LHC324/ABB-Technical-commutation_new/document/迪文屏幕变动说明.txt

1、首页：加入RTC。
2、开发者模式：加时间、亮度设置、网络时间获取、屏幕时间下发、wifi串口参数。
3、自动测试、手动测试电压单位V、电流单位mA，偏差率单位%。
4、分级手动：交直流选项框去掉（段号变更为组号）。
5、手动测试：段号：起始段号、结束段号。
6、段号变更为组号，原来8段变为7组。每3个端点为1组。（分级手动）
7、用户频率设定部分：仅预留低频（0HZ）、中频（50HZ）、高频（1-20Khz）选项框。
8、开发者模式：去掉段号、增加一个wifi复位按钮、WiFi恢复出厂设置按钮。
9、自动模式、手动模式去掉数据保存按钮。
