LHC324/ABB-Technical-commutation_new/document/Sphinx/高压断路器动特性测试仪使用说明书  V1.0.1 .pdf

- » 高压断路器动特性测试仪 V1.0.1 文档

# 高压断路器动特性测试仪使用说明书

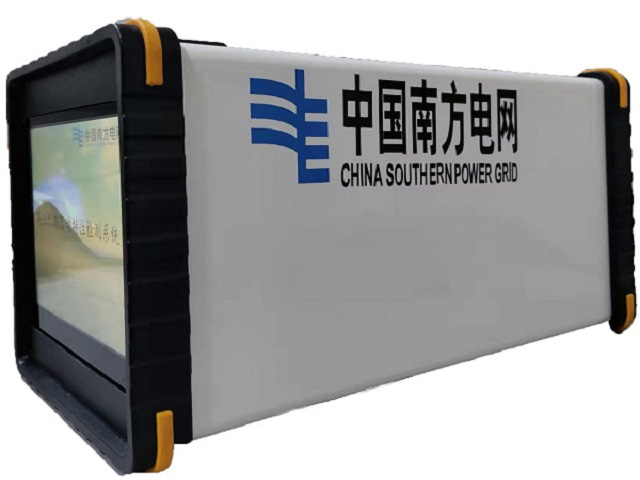
[picture p16: figure]

公司主页（homepage）：http://www.ynpax.com/cn/home/index.asp合作方主页：http://www.yn.csg.cn/
公司地址:云南省昆明市经开区云大西路39号创业大厦C栋202室
联系电话:0871-6732300/67322190
目录

## 1. 概述

本产品为高压断路器动特性测试仪，公司遵循国家行业执行标准： GB10963.1-2005 ,确属本公司 产品质量问题，自购置之日起保修期为3个月(非正常使用而致使产品损坏，烧坏的，不属保 修之列)。

高压断路器是高低压电器回路中执行线路通断的执行机构，承担着线路合闸、分闸工作。 断路器性能的好坏直接影响着输变电环节的安全生产过程，因此在各换流站大量使用的高 压断路器需要保持持续有效的性能检测。 然而，由于高压断路器安装位置高、使用数量 多，在传统的生产检测环节，需要动用大型辅助升降设备协助操作人员进行断路器检测信 号线的接驳和断开，不仅生产效率低下，而且存在高危、高风险、工作量巨大、协同人员 多的诸多缺点。为了降低换流站检修人员工作风险，实现在限定时间站内所有高压断路器 的检测工作，本项目拟设计一款高压断路器快速分合闸检测装置，将操作人员从多人员协 同、重复线路接驳、操作繁琐的检测工作中解放出来，实现线路一次接驳重复测试，单人 操作快速检测断路器特性的复杂测试过程。 低压断路器是现代控制中广泛使用的线路分断

执行机构，在生产现场的控制柜内大量使用了不同线圈电压、不同触点耐压和电流容量的 低压接触器，此类接触器虽然功率较小，但是承担着监测、控制线路中信号传递的作用， 如果各关键控制信号在控制系统和现场检测仪表之间传输时，由于接触器性能下降导致的 误触发或抖动，都会导致控制系统判断失误，引起错误的执行结果，甚至引起控制失败。 在实际应用中，由于控制回路或信号传输回路异常导致的系统误动作频繁发生，不仅造成 生产成本增加，甚至可能由于错误的动作导致巨大损失。
因此，无论高压断路器还是低压断路器，其 | 机械、电气 | 特性的优良直接影响着生产安全和
控制安全。由于所有接触器一旦接入现场使用就无法全部拆下检测，其工作特性和参数检 测均需在现场进行。在传统的检测过程中，由于缺乏专用的检测手段和检测工具，工作人 员往往需要付出巨大的劳动时间、人员数量和时间成本才能完成所有甚至部分现场断路器 的特性检测。然而由于检测手段和检测设备导致的测试结果异常也屡屡发生，反复的测试 验证工作更是加重了测试工作的劳动强度并延长了测试时间。对于需要在限定时间内按时 完成检修任务的现场检测工作，对所有现场测试人员都是一个巨大的考验。

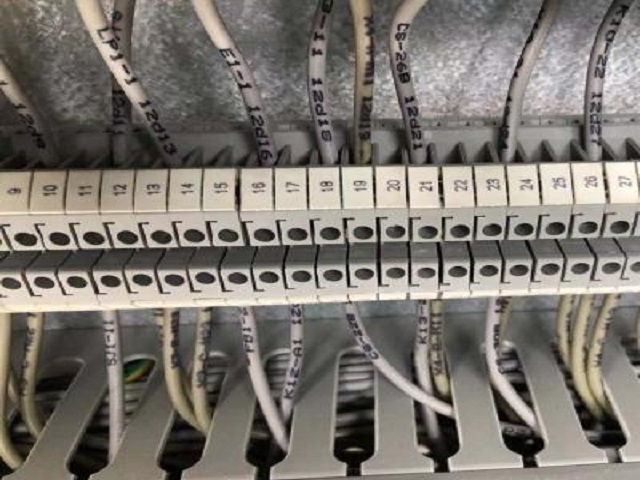
[picture p17: figure]

图 1.1 低压断路器控制回路

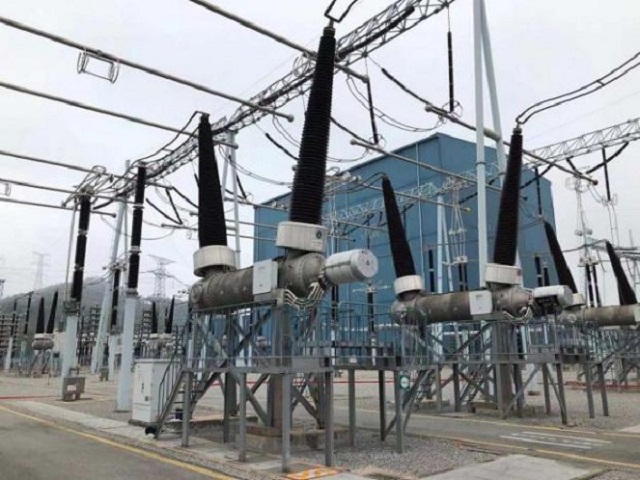
[picture p18: figure]

图 1.2 高压断路器控制回路

## 2. 技术特性

本产品高速脉冲采样速率高达10MHz
本产品最多同时支持六通道同步/异步进行测量，测量精度可达0.01ms 本产品内置12V/7Ah * 2个超长寿命电池，可持续至少一周连续使用，并且具有高达500次 以上的充放电循环周期
本产品具有低功耗特性，待机状态电流可低至2.43uA 本产品自带充电保护功能，可避免大部分使用过程中由于电源造成的安全问题 本产品带有WIFI物联网功能，可把检测数据保存至物联网终端，以备查阅（WIFI模块可 选）

## 3. 设计原理

### 3.1. 低压断路器测试工具设计原理

如 | 图1.1 | 所示，在控制柜内大量安装的低压断路器，其控制信号（根据线圈驱动电压类型
不同可分为：直流、交流， 根据驱动线圈的电压幅值又可分为不同电压类型的断路器）和 触头干接点是整个控制的核心和灵魂，二者具有随动的特点， 当断路器线圈电压出现在线 圈上时其控制线圈由于得电而产生磁性，实现断路器触头的吸合和分断，从而满足信号电 压或驱动电压的传输 和断开。
- 注意

由于大量断路器安装在现场控制柜内，为了实现断路器特性的现场检测，必须由操作人员 将测试设备在现场接入断路器的控制回路和 触点位置，实现自动或手动控制断路器的吸合 或分断，并由测试仪器分析其断路器相对应驱动电压信号和触点信号断开和接通的机械和

电气特性，实现断路器在线特性检测，从而识别存在安全隐患的断路器，确保检修工作的 顺利完成，为换流变安全生产提供间接或直接的 技术保障。

根据图1.1所示的控制柜，由于现场位置拥挤，操作不方便等特点，传统采用多人协作对 断路器进行特性检测的过程，具有需要协同人员数量多、 检测效率低下、操作不便的大量 局限性急需解决。
因此，本案将设计一款专用柜用断路器特性现场检测工具，实现单人检测和数据自动录入 的工作，其工作原理如下:

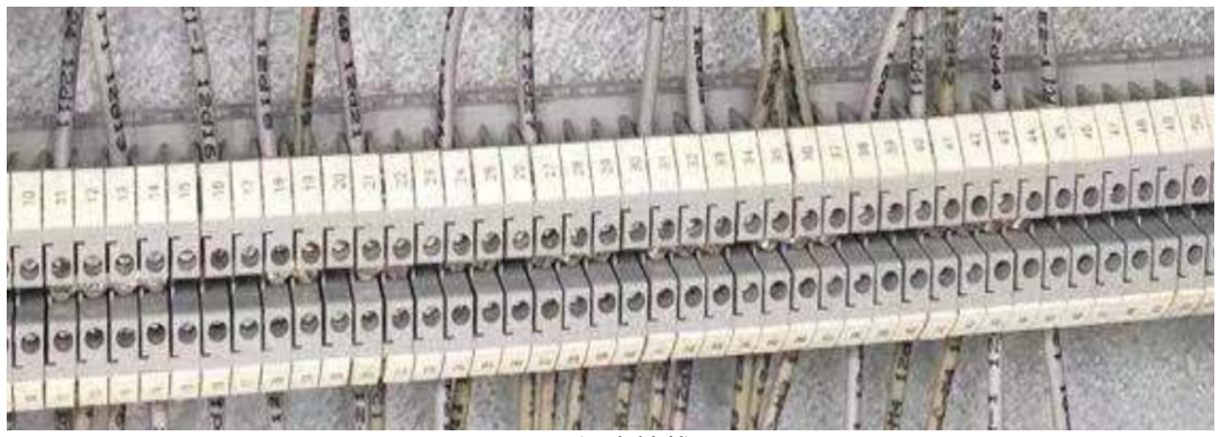
[picture p19: figure]

图 3.1.1 柜内接线图

- 注解

上图中，接线端子上连接的就是柜子内断路器的线圈控制信号线、触点信号线的连接线， 要实现断路器性能的现场检测，可通过在此接线端子上的间接检测而实现。 同时，由于在 此处检测同时兼具断路器本身和线路接触性能的检测，正所谓一举两得。

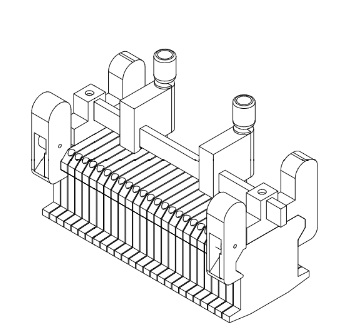
[picture p20: figure]

图 3.1.2 接线端子自动夹具结构设计图

左固定钩、由固定钩：是用来钩定在线槽上，为固定探针提供稳固的平台支 撑。
滑块A、滑块B：当线槽固定夹具固定后，滑动滑块A和滑块B到相对应的引出线 螺栓处，为探针提供水平方向的矫正调节。
探针A、探针B：当滑块移动到对应的出线位置后，下压探针分别接触到线槽固 定夹具下端的出线端子螺栓上，实现信号线的固定连接。

通过以上操作，可实现一人操作，固定不同断路器引出线的目的，线路和探针连接好以后 即可实现测试过程。在整个测试过程中， 操作人员无需全程手持探针保持接触，实现测量 过程无人化。
测得的断路器特性和信号，被存储在测试仪内部，可通过WIFI或USB连接线传送到PC保 存和使用。

### 3.2. 高压断路器测试工具设计原理

如 | 图1.2 | 所示，高压断路器是换流站线路控制的通断控制器件，承担着输电线路的接通和
断开。由于高压断路器工作在高电压、大电流状态， 其机械和电气特性都直接决定着输电 过程的安全。对于换流站内大量使用的高压断路器，为了确保其性能的可靠和工作安全， 必须在年度或不定期检修中 完成对其所有电气和机械性能的测试工作。然而，由于高压断 路器在换流站内数量多，体积庞大，拆装困难，因此无法将断路器在限定时间内全部拆下 在进行检测。
- 注意

因此，在传统的检修过程中，一般采用绝缘杆配合挂钩的方式进行，但是由于断路器在测 试通过和动过过程中会产生强烈的震动，从而导致测量 结果错误，此方法在实际测量中无 法完成正确测量。

为了解决上述测量方法导致的错误，实际测量时必须采用鳄鱼夹等具有防松、防震动的夹 具连接十米线，从而确保测量结果的准确性。 由于高压断路器安装位置的特点，此方法必 须动用自动升降设备才能将操作人员抬升到高压断路器最高处，实现人工连接10米线的过 程。此种方法具有动用设备多，人员风险大，工作强度大的严重缺席，无法实现高效的测 量过程。
在此，此项目提出研发一款专用高压断路器10米线连接夹具。此夹具具有简单连接，低空 作业，手动锁紧和解锁功能，夹具锁紧后具有接触良好，防抖动和松脱的特点，此夹具安 装在绝缘杆顶端，操作人员需要锁紧线缆时只 需将锁紧头对准要锁紧的线缆并上推，夹具 下口受力后推动带有弹簧锁紧装置的鸭舌下压，完成锁紧动作，夹具锁紧后在弹簧的作用 下具有防松特性。当测量完毕需要将夹具松开时，操作人员在地面用力下拉绝缘杆， 此时 鸭舌上抬并拉动弹簧实现弹簧拉力偏心，完成鸭舌张开动作，实现线缆松开动作。

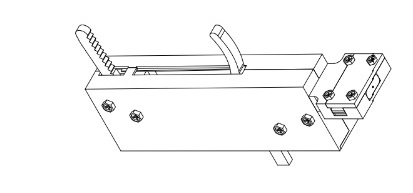
[picture p21: figure]

图 3.2.1 高空自动夹具结构设计图

- 注解

基本工作原理：如上图，当需要加紧线缆时，将线缆穿过上下鸭舌之间，此时从下往上推 动下鸭舌，由于咬合顶针的作用推动上鸭舌执行逆时针转动，由于弹簧的中心位置在绝缘 杆的中心位置，当弹簧拉力出现向左或向右偏移时， 在弹簧的拉力下即可实现鸭舌的张开 或闭合，利用弹簧的拉力即可实现防震动加紧。

同时以上夹具安装在绝缘杆顶端，操作人员可以在地面利用延长的绝缘杆实现上推咬合鸭 舌，或下拉松开鸭舌的动作，满足在高压断路器测试时高效夹紧或松开断路器测试端子的 目的。

## 4. 结构特性

此部分，暂不做说明。

## 5. 操作指南

### 5.1. 后盖接线组说明

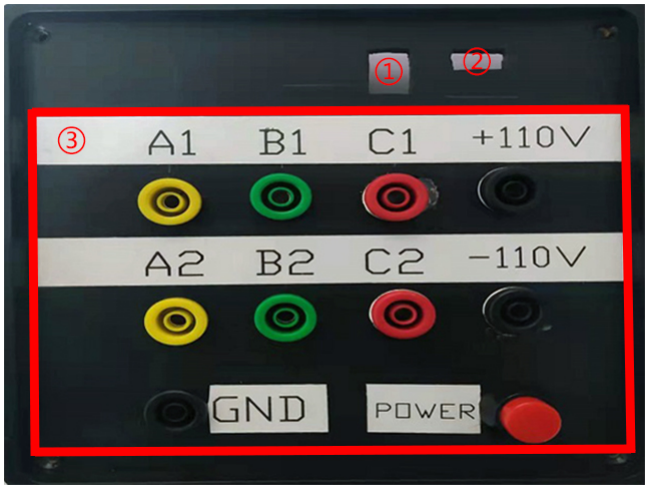
[picture p22: figure]

图 5.1.1 后盖接线组

① 区域为 12V/2ADC 充电电压输入口，当设备电池电压过低时通过该接口进行充电。 ② 区域为 USB-C 双线数据交互口，目前暂未添加任何功能。
③ 区域为 六通道数据采集接线组及正负110V电压采集接线口 ，是主要功能接线区域。

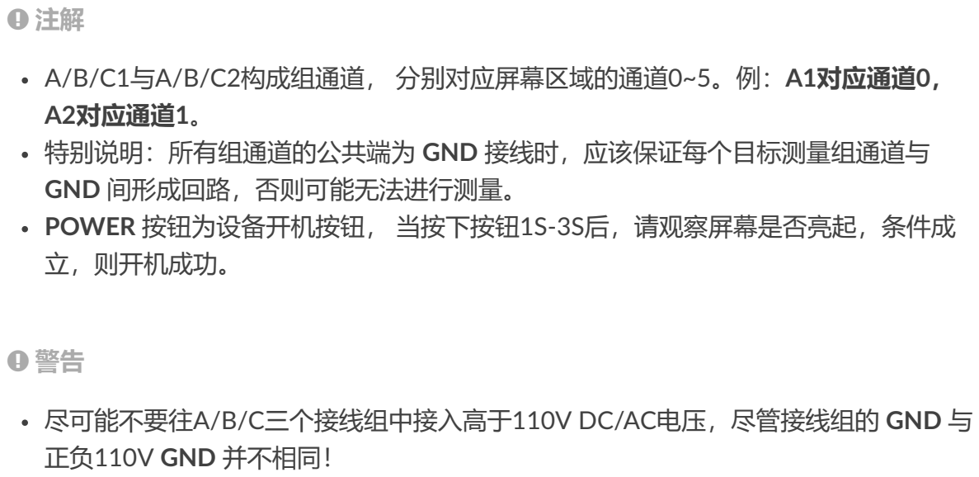
[picture p23: figure]
A/B/C1与A/B/C2构成组通道， 分别对应屏幕区域的通道0~5。例：A1对应通道0， A2对应通道1。 特别说明：所有组通道的公共端为 GND 接线时，应该保证每个目标测量组通道与 GND 间形成回路，否则可能无法进行测量。 POWER 按钮为设备开机按钮， 当按下按钮1S-3S后，请观察屏幕是否亮起，条件成 立，则开机成功。; 尽可能不要往A/B/C三个接线组中接入高于110V DC/AC电压，尽管接线组的 GND 与 正负110V GND 并不相同！
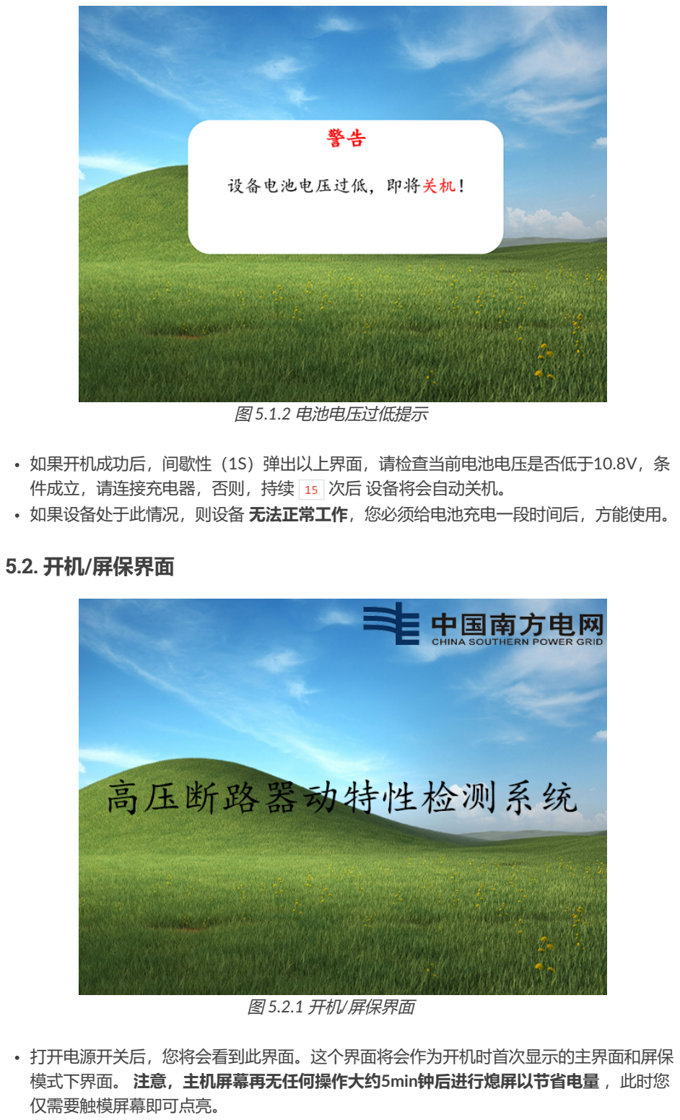
[picture p24: page 8]

图 5.1.2 电池电压过低提示

如果开机成功后，间歇性（1S）弹出以上界面，请检查当前电池电压是否低于10.8V，条
件成立，请连接充电器，否则，持续 | 15 | 次后 设备将会自动关机。
如果设备处于此情况，则设备 无法正常工作，您必须给电池充电一段时间后，方能使用。

### 5.2. 开机/屏保界面

图 5.2.1 开机/屏保界面

打开电源开关后，您将会看到此界面。这个界面将会作为开机时首次显示的主界面和屏保 模式下界面。 注意，主机屏幕再无任何操作大约5min钟后进行熄屏以节省电量 ，此时您 仅需要触模屏幕即可点亮。

### 5.3. 前台界面

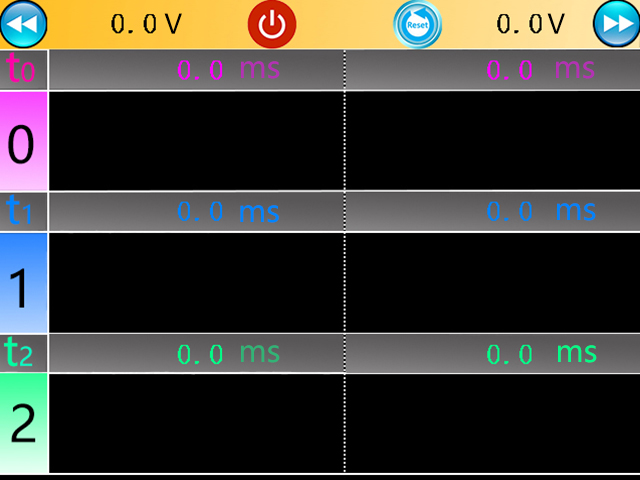
[picture p25: figure]

图 5.3.1 主界面1

此界面主要由类型操作按钮、两次测量时间以及两次测量波形三部分构成。 左边第一个按钮为 返回上一页（开机/屏保界面） ，您触摸它将会触发相应功能。 中间第一个按钮为 关机 ，您触摸它将会触发相应功能。
中间第二个按钮为 复位，您触摸它将会触发相应功能。
最右边按钮为 跳转到下一页（主界面二） ，您触摸它将会触发相应功能。

图 5.3.2 菜单栏1

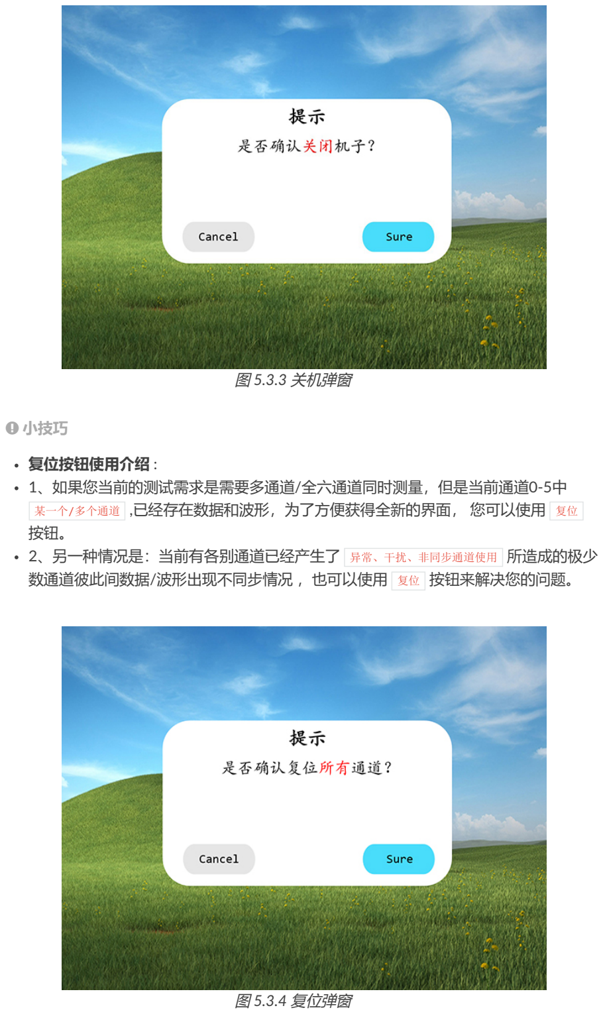
[picture p26: page 10]

图 5.3.3 关机弹窗

- 小技巧

复位按钮使用介绍 :
1、如果您当前的测试需求是需要多通道/全六通道同时测量，但是当前通道0-5中
某一个/多个通道 | ,已经存在数据和波形，为了方便获得全新的界面， 您可以使用 | 复位
按钮。
2、另一种情况是：当前有各别通道已经产生了 | 异常、干扰、非同步通道使用 | 所造成的极少
数通道彼此间数据/波形出现不同步情况 ，也可以使用 | 复位 | 按钮来解决您的问题。

图 5.3.4 复位弹窗

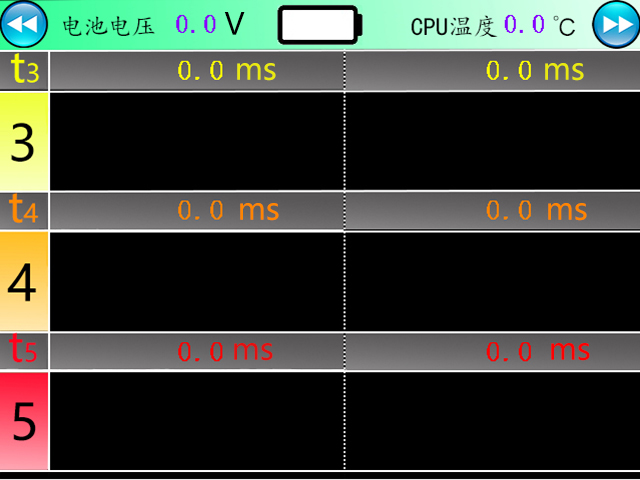
[picture p27: figure]

图 5.3.5 主界面2

左边显示的是当前 电池电压。
中间显示的是当前电压对应的 电池图标。
最右边显示的是当前 CPU温度 ，它将会告诉您当前环境是否适合设备工作。

图 5.3.6 菜单栏2

图 5.3.1 和图 5.3.5 共同构成高压断路器动特性检测仪的前台界面，通道按0-5顺序排列。

图 5.3.7 测量结果显示栏

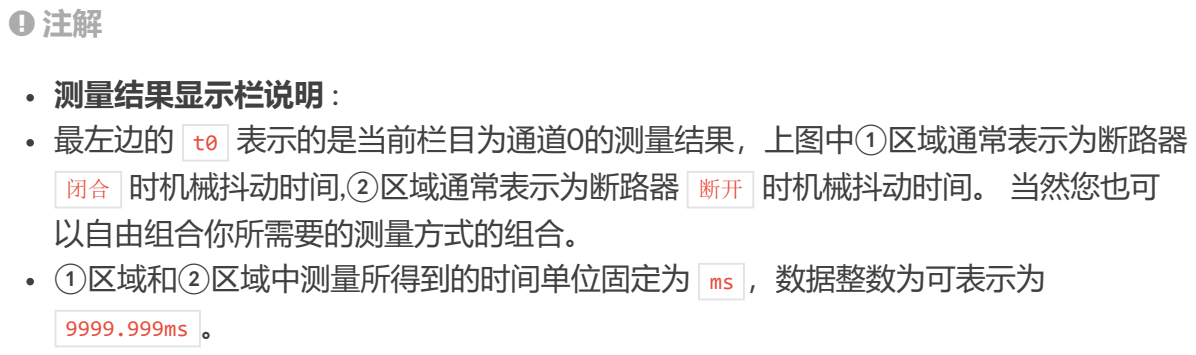
[picture p28: figure]
测量结果显示栏说明 :; 最左边的; 表示的是当前栏目为通道0的测量结果，上图中①区域通常表示为断路器; 时机械抖动时间,②区域通常表示为断路器; 时机械抖动时间。 当然您也可; 以自由组合你所需要的测量方式的组合。; ①区域和②区域中测量所得到的时间单位固定为; ，数据整数为可表示为
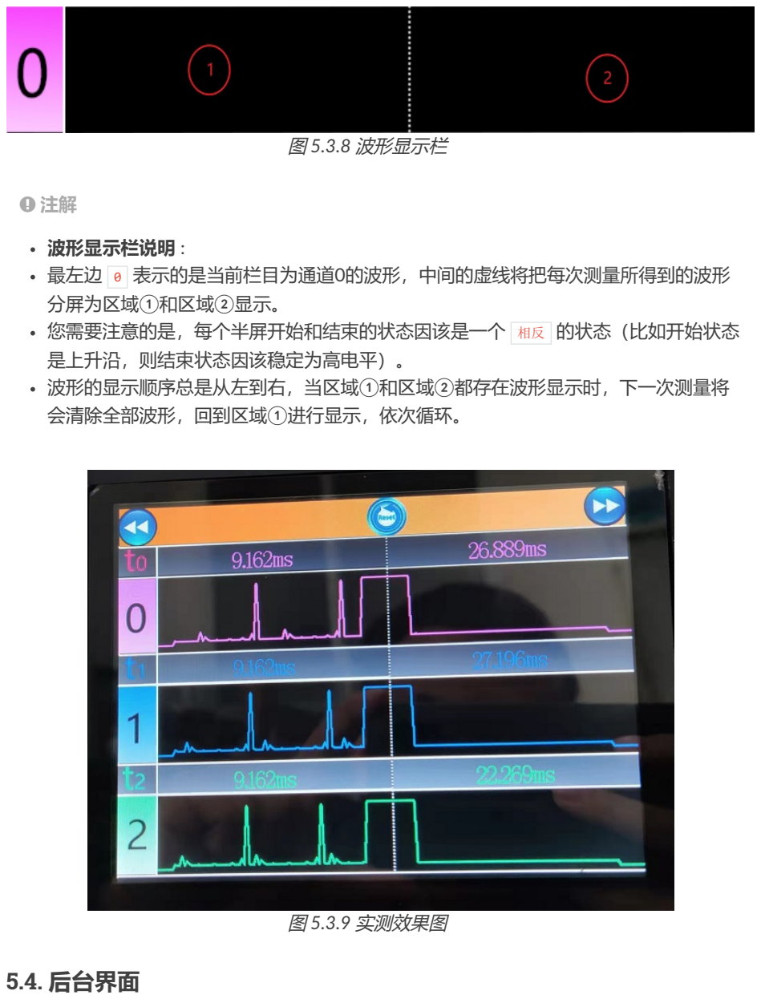
[picture p29: page 12]

图 5.3.8 波形显示栏

- 注解

波形显示栏说明 :
最左边 | 0 | 表示的是当前栏目为通道0的波形，中间的虚线将把每次测量所得到的波形
分屏为区域①和区域②显示。
您需要注意的是，每个半屏开始和结束的状态因该是一个 | 相反 | 的状态（比如开始状态
是上升沿，则结束状态因该稳定为高电平）。
波形的显示顺序总是从左到右，当区域①和区域②都存在波形显示时，下一次测量将 会清除全部波形，回到区域①进行显示，依次循环。

图 5.3.9 实测效果图

### 5.4. 后台界面

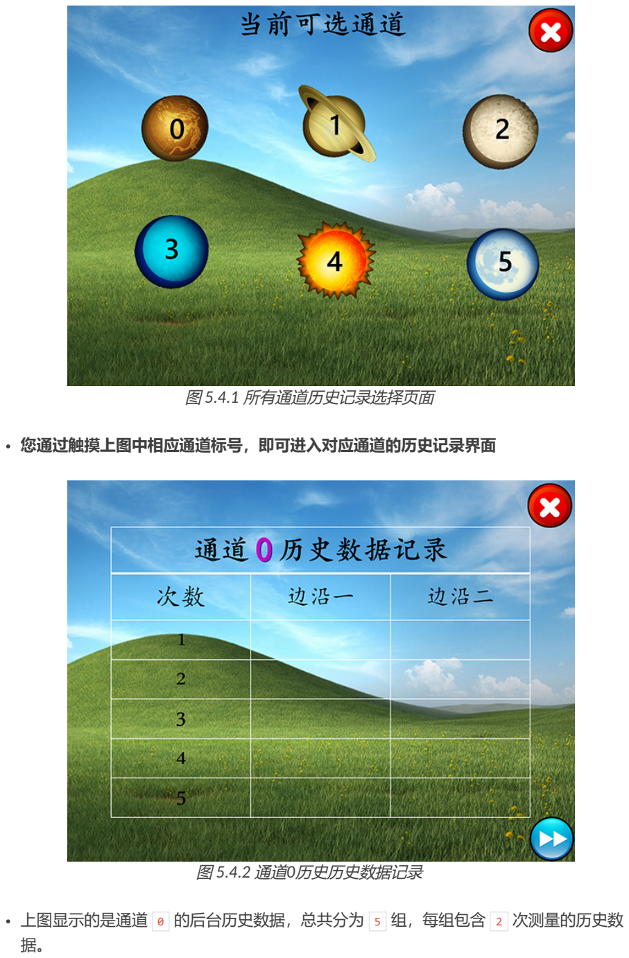
[picture p30: page 13]

图 5.4.1 所有通道历史记录选择页面

您通过触摸上图中相应通道标号，即可进入对应通道的历史记录界面

图 5.4.2 通道0历史历史数据记录

上图显示的是通道 | 0 | 的后台历史数据，总共分为 | 5 | 组，每组包含 | 2 | 次测量的历史数
据。

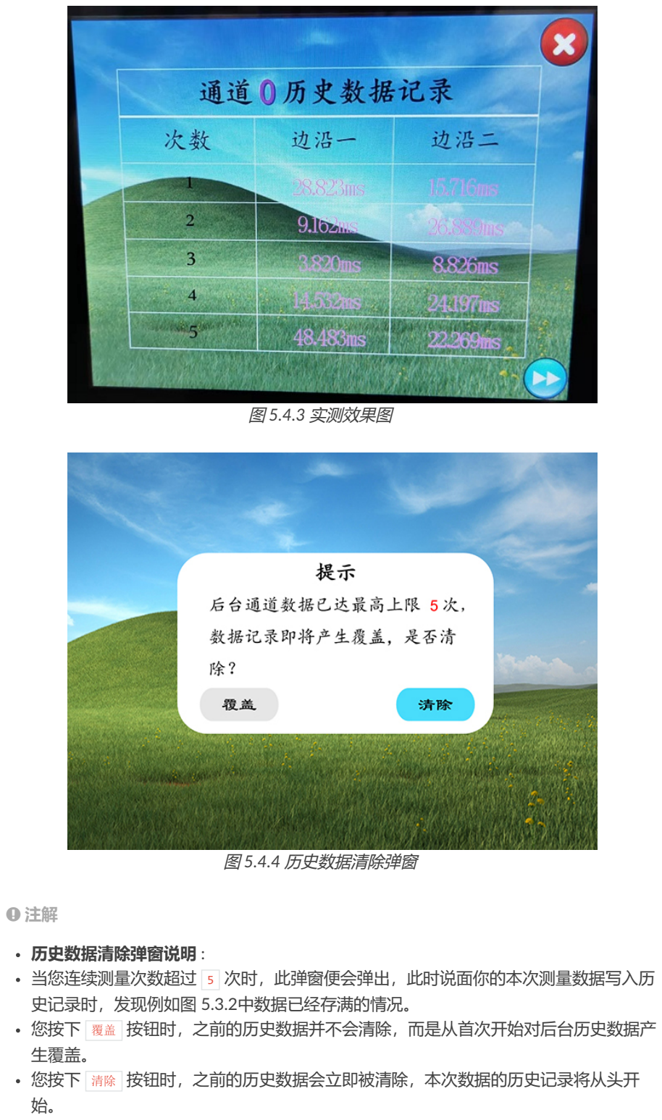
[picture p31: page 14]

图 5.4.3 实测效果图

图 5.4.4 历史数据清除弹窗

- 注解

历史数据清除弹窗说明 :
当您连续测量次数超过 | 5 | 次时，此弹窗便会弹出，此时说面你的本次测量数据写入历
史记录时，发现例如图 5.3.2中数据已经存满的情况。
您按下 | 覆盖 | 按钮时，之前的历史数据并不会清除，而是从首次开始对后台历史数据产
生覆盖。
您按下 | 清除 | 按钮时，之前的历史数据会立即被清除，本次数据的历史记录将从头开
始。

## 6. 注意事项

本产品需要在合适温度下使用。
本产品正常使用需要按照操作指导部分规范操作。

## 7. 故障分析与排除

略。

## 8. 维修与保养

索引
模块索引
搜索页面
