LHC324/ABB-Technical-commutation_new/document/ADC2_50Hz.jpg

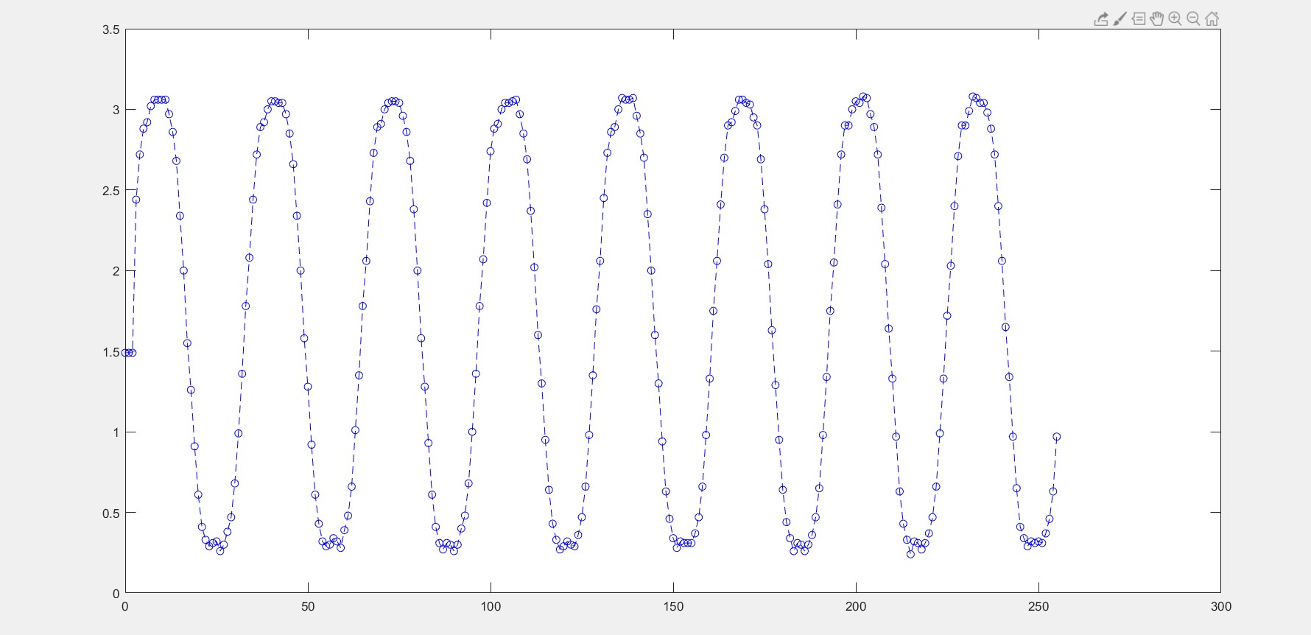
document/ADC2_50Hz.jpg
