LHC324/ABB-Technical-commutation_new/document/ADC3_50Hz.jpg

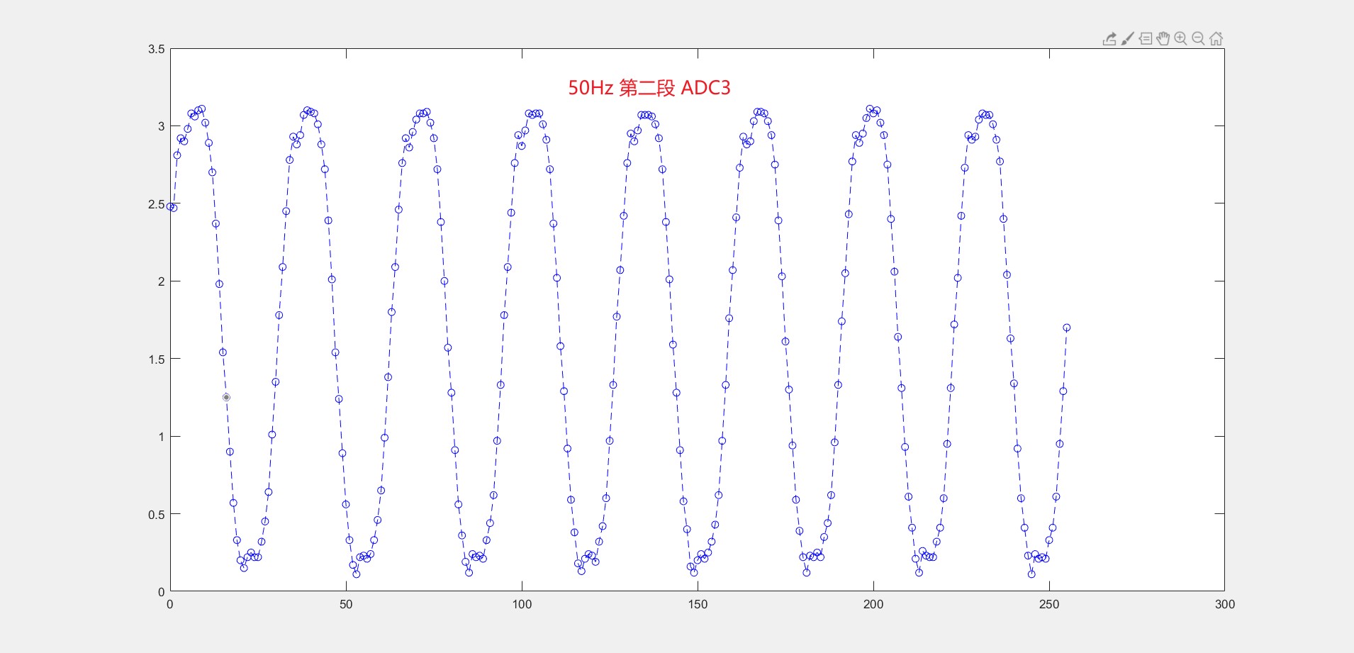
document/ADC3_50Hz.jpg
