LHC324/ABB-Technical-commutation_new/document/keil警告信息控制.jpg

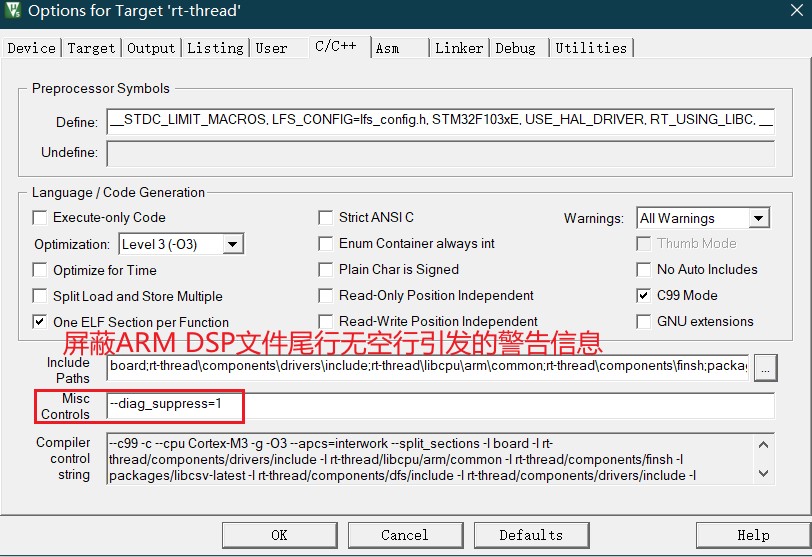
document/keil警告信息控制.jpg
