LHC324/ABB-Technical-commutation_new/document/交流电采样点.jpg

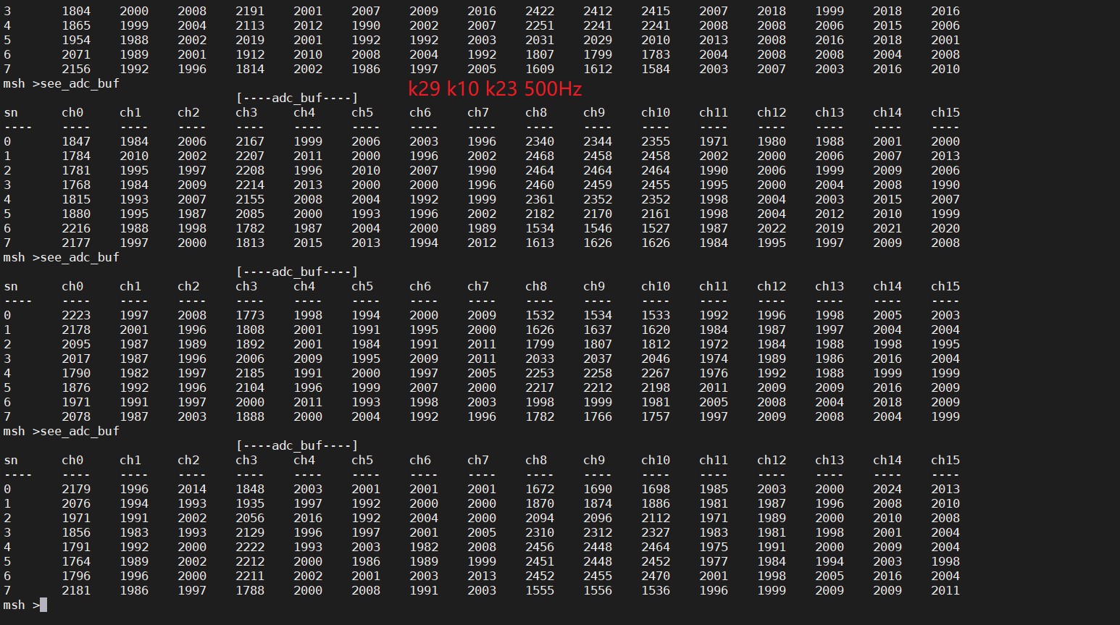
document/交流电采样点.jpg
