LHC324/ABB-Technical-commutation_new/document/操作时系说明.jpg

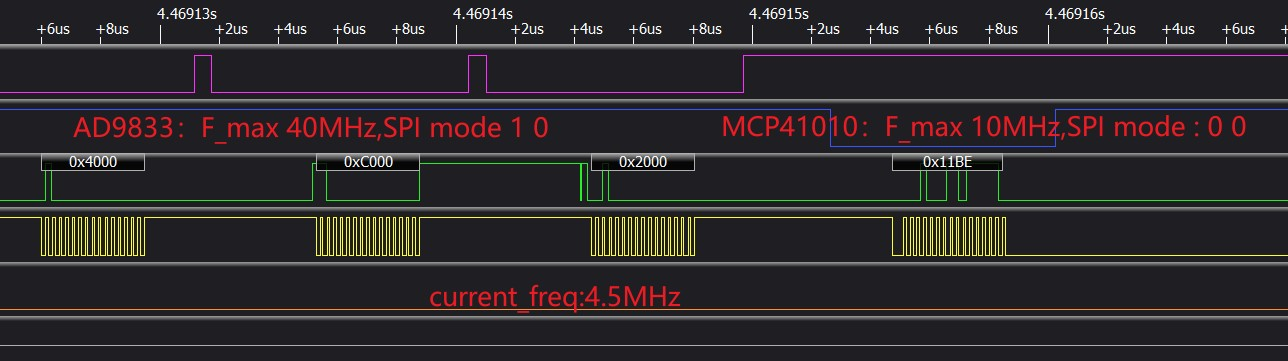
document/操作时系说明.jpg
