LHC324/ABB-Technical-commutation_new/document/Sphinx/测试仪图纸/电线夹.DXF

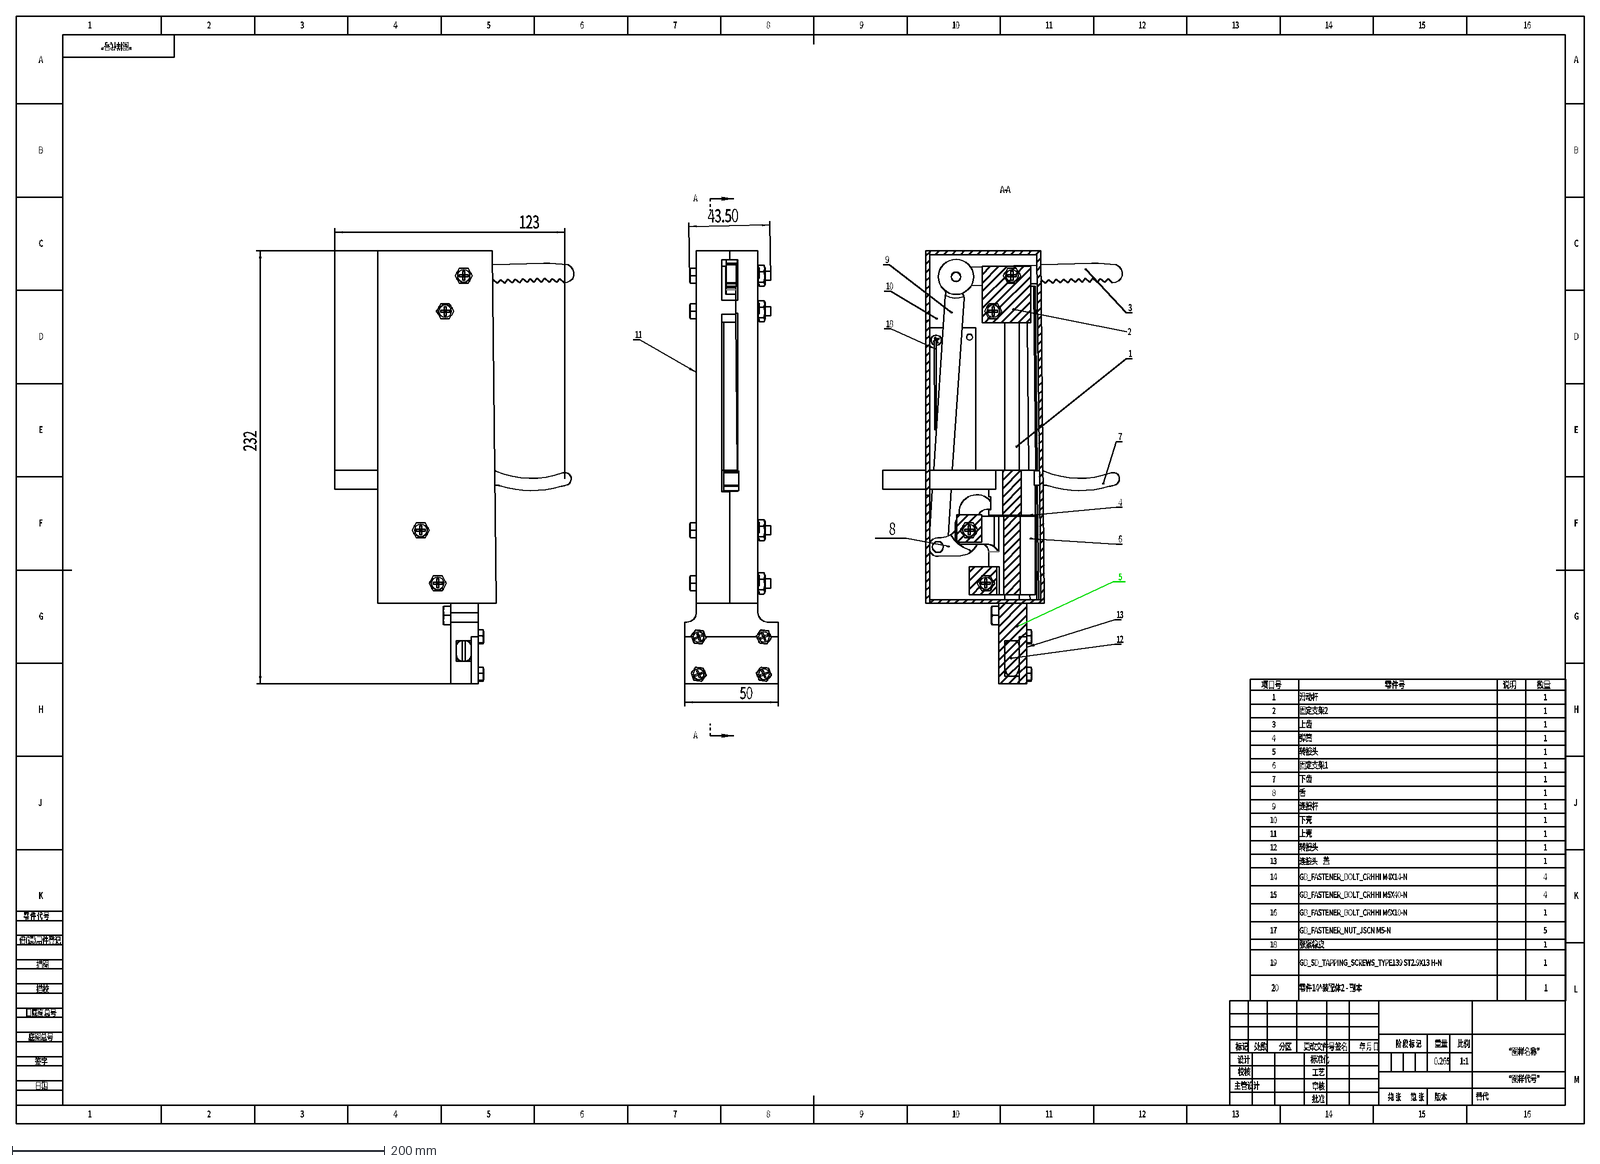
[picture p59: CAD file, 2022-11-03]
document/Sphinx/测试仪图纸/电线夹.DXF
审核
设计
标记
处数
分区
更改文件号
签名
年 月 日
工艺
标准化
批准
阶 段 标 记
共 张
第 张
重量
比例
日期
签字
底图总号
旧底图总号
描校
描图
借(通)用件登记
零 件 代 号
版本
替代
“图样代号”
校核
主管设计
“图样名称”
0.265
1
1:1
2
15
14
13
12
11
10
9
8
7
6
5
4
3
16
B
C
D
E
F
G
H
J
K
A
L
M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
