LHC324/ABB-Technical-commutation_new/(list of files, cad)

Other CAD files:
document/Sphinx/测试仪图纸/电线夹.SLDDRW
document/Sphinx/测试仪图纸/电线夹二维图.SLDDRW
