LHC324/ABB-Technical-commutation_new/document/Sphinx/source/te_characteristics.rst

技术特性
===========

* **本产品高速脉冲采样速率高达10MHz**
* **本产品最多同时支持六通道同步/异步进行测量，测量精度可达0.01ms**
* **本产品内置12V/7Ah * 2个超长寿命电池，可持续至少一周连续使用，并且具有高达500次以上的充放电循环周期**
* **本产品具有低功耗特性，待机状态电流可低至2.43uA**
* **本产品自带充电保护功能，可避免大部分使用过程中由于电源造成的安全问题**
* **本产品带有WIFI物联网功能，可把检测数据保存至物联网终端，以备查阅（WIFI模块可选）**
