LHC324/ABB-Technical-commutation_new/document/ymodem_issue1.jpg

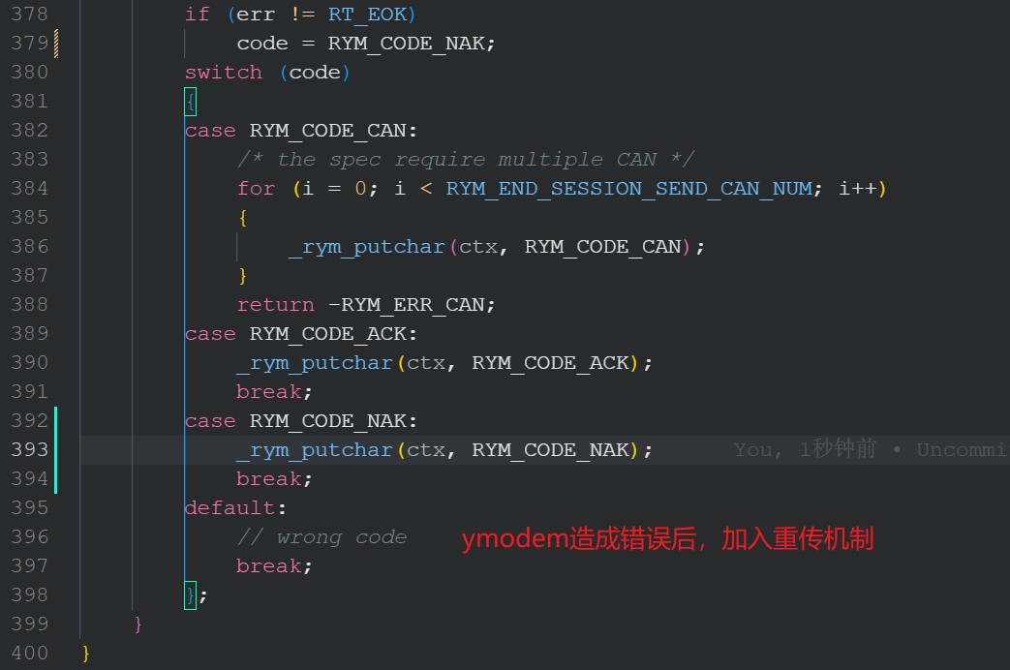
document/ymodem_issue1.jpg
