LHC324/ABB-Technical-commutation_new/document/均压测试V2.pdf

23 4 8

23 4 8

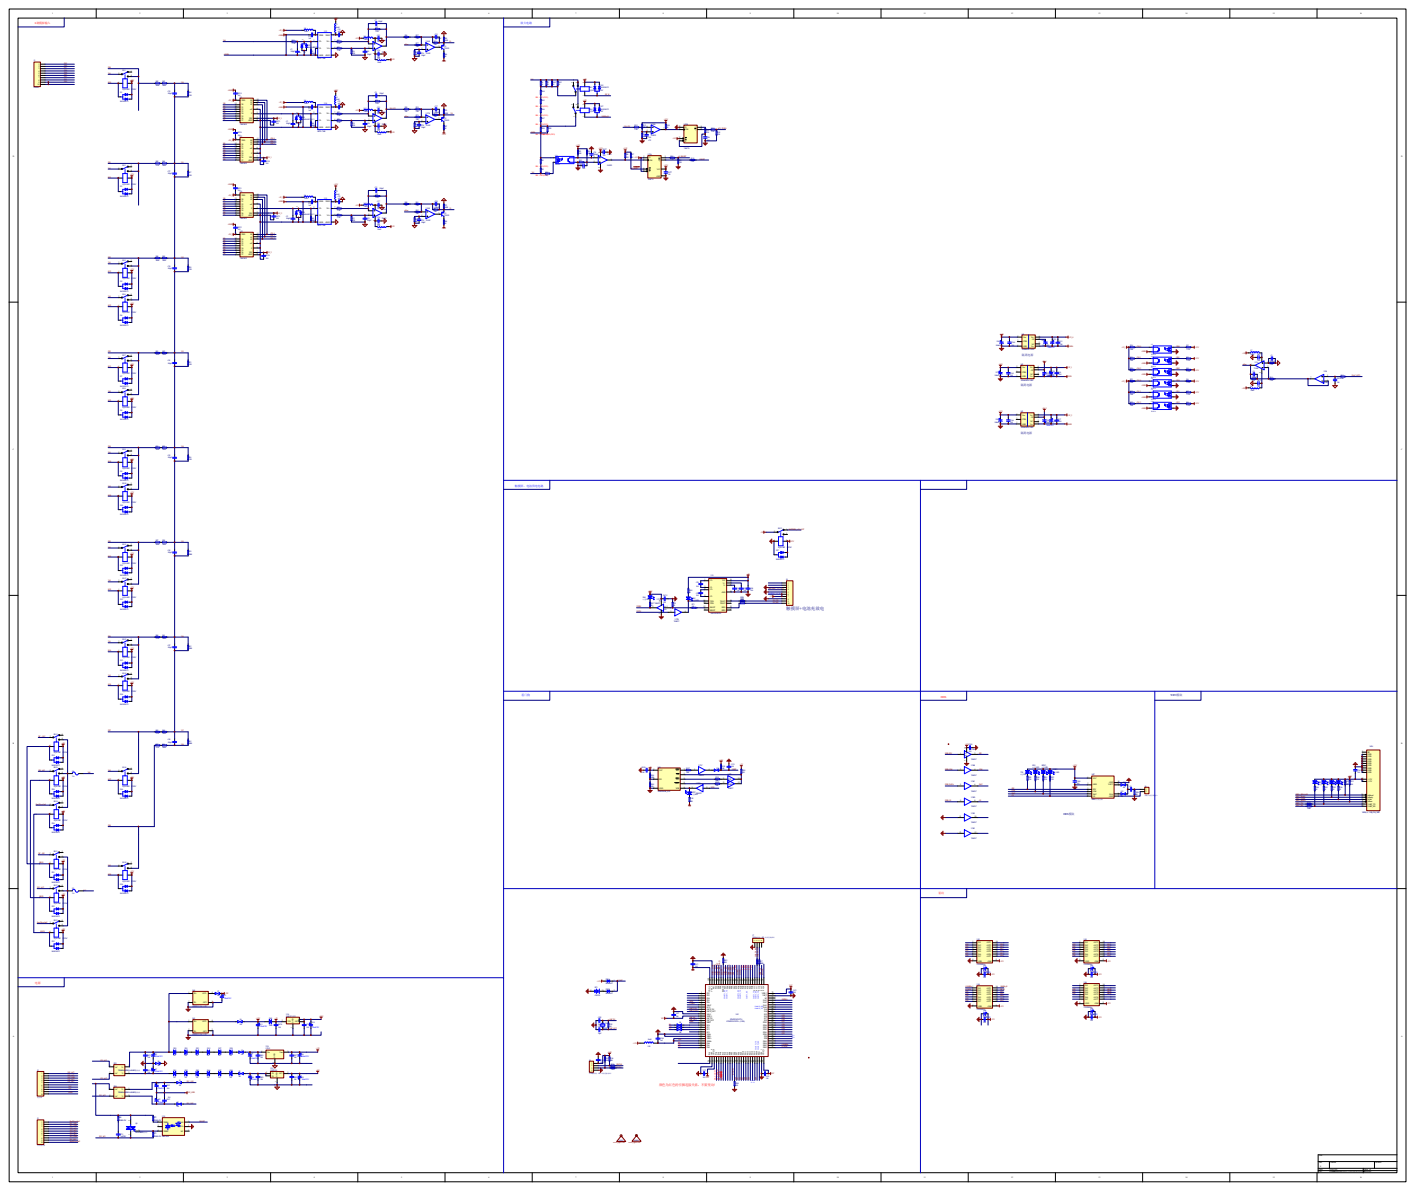
[picture p61: page 1]
