LHC324/ABB-Technical-commutation_new/document/智能型ABB技术路线换流阀均压测试装置V1.pdf

## 8路模拟输入

23 4 8

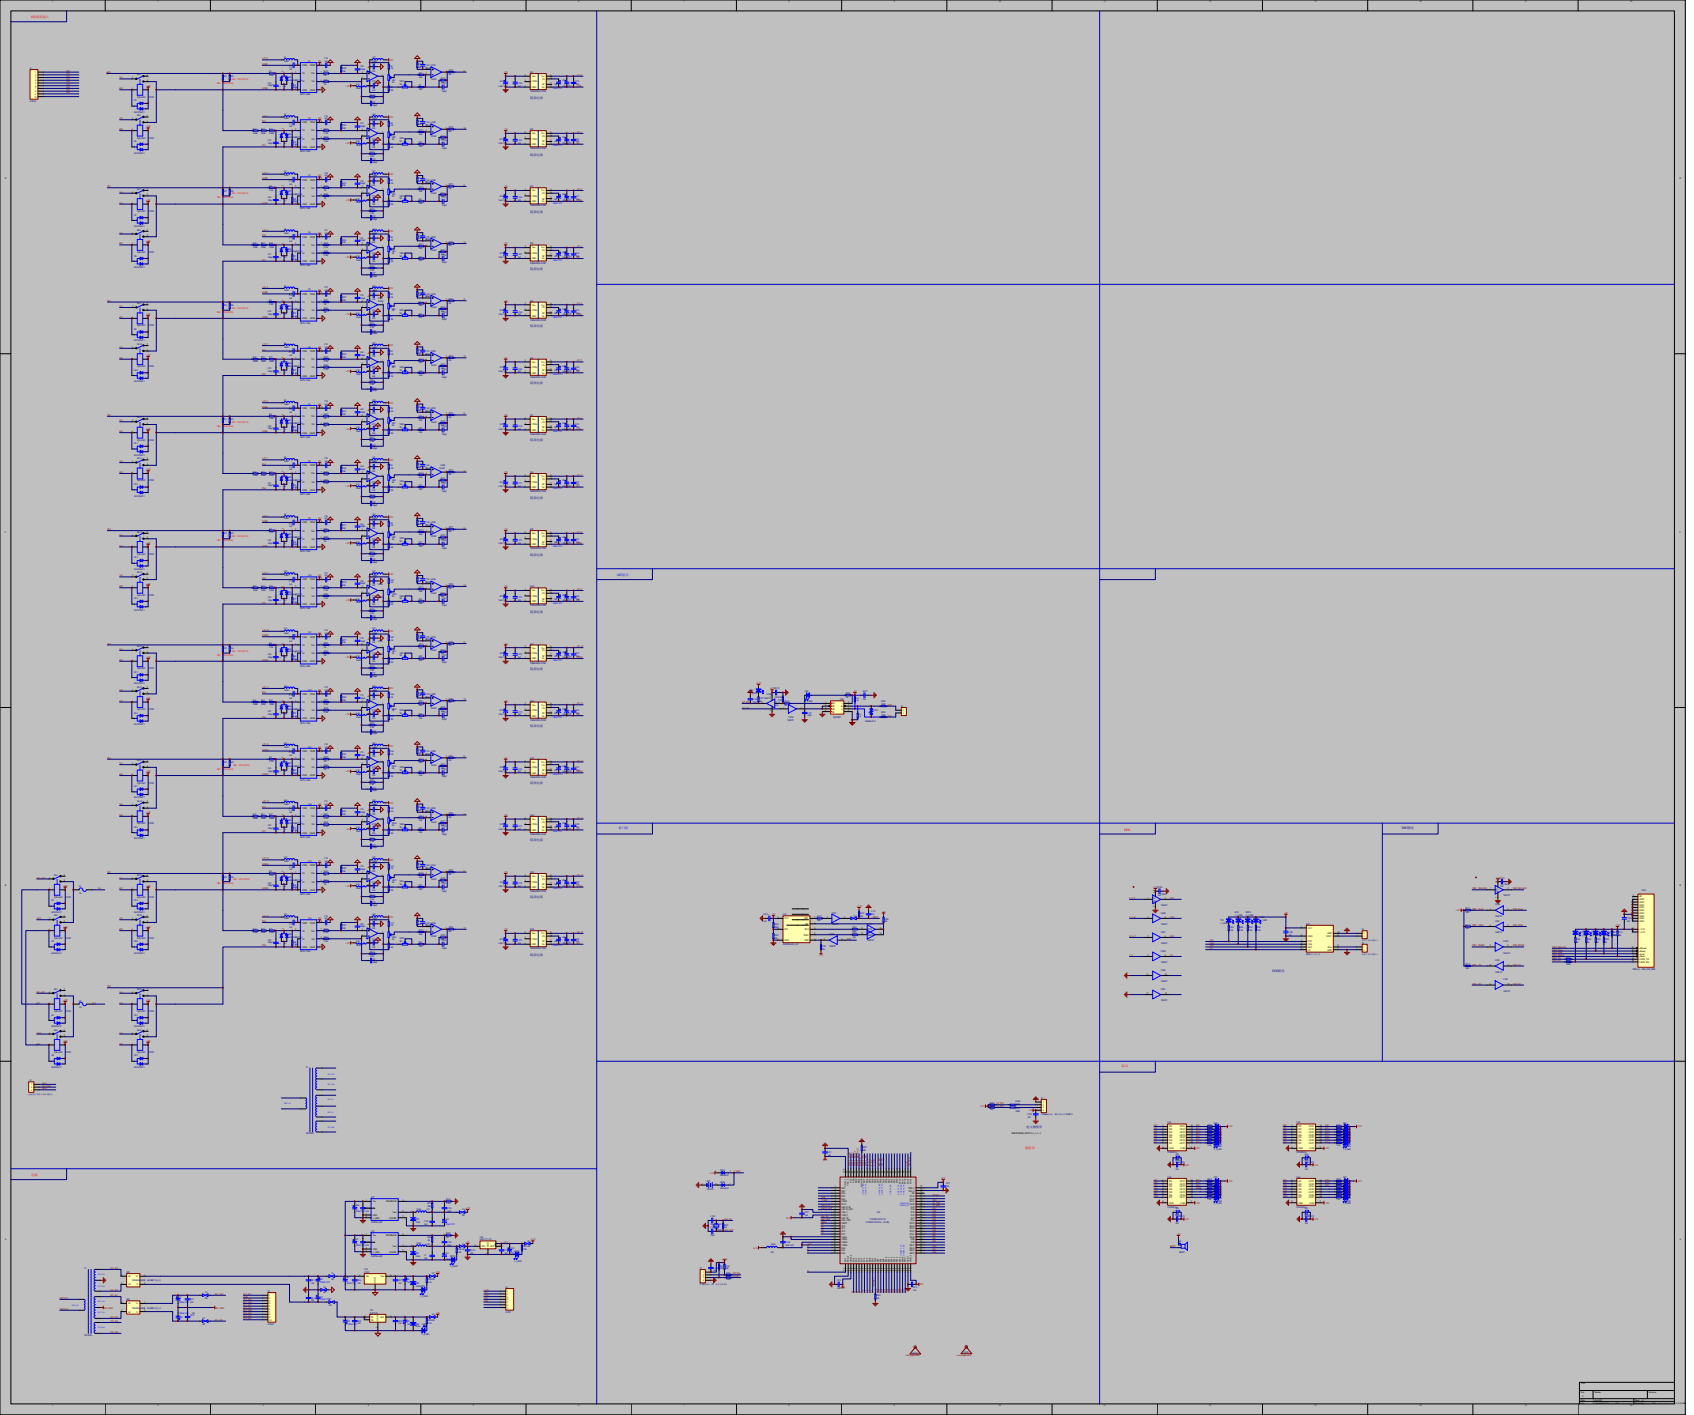
[picture p62: page 1]
