LHC324/ABB-Technical-commutation_new/document/阀段测试CPU-V1.pdf

8

# C31uFR7

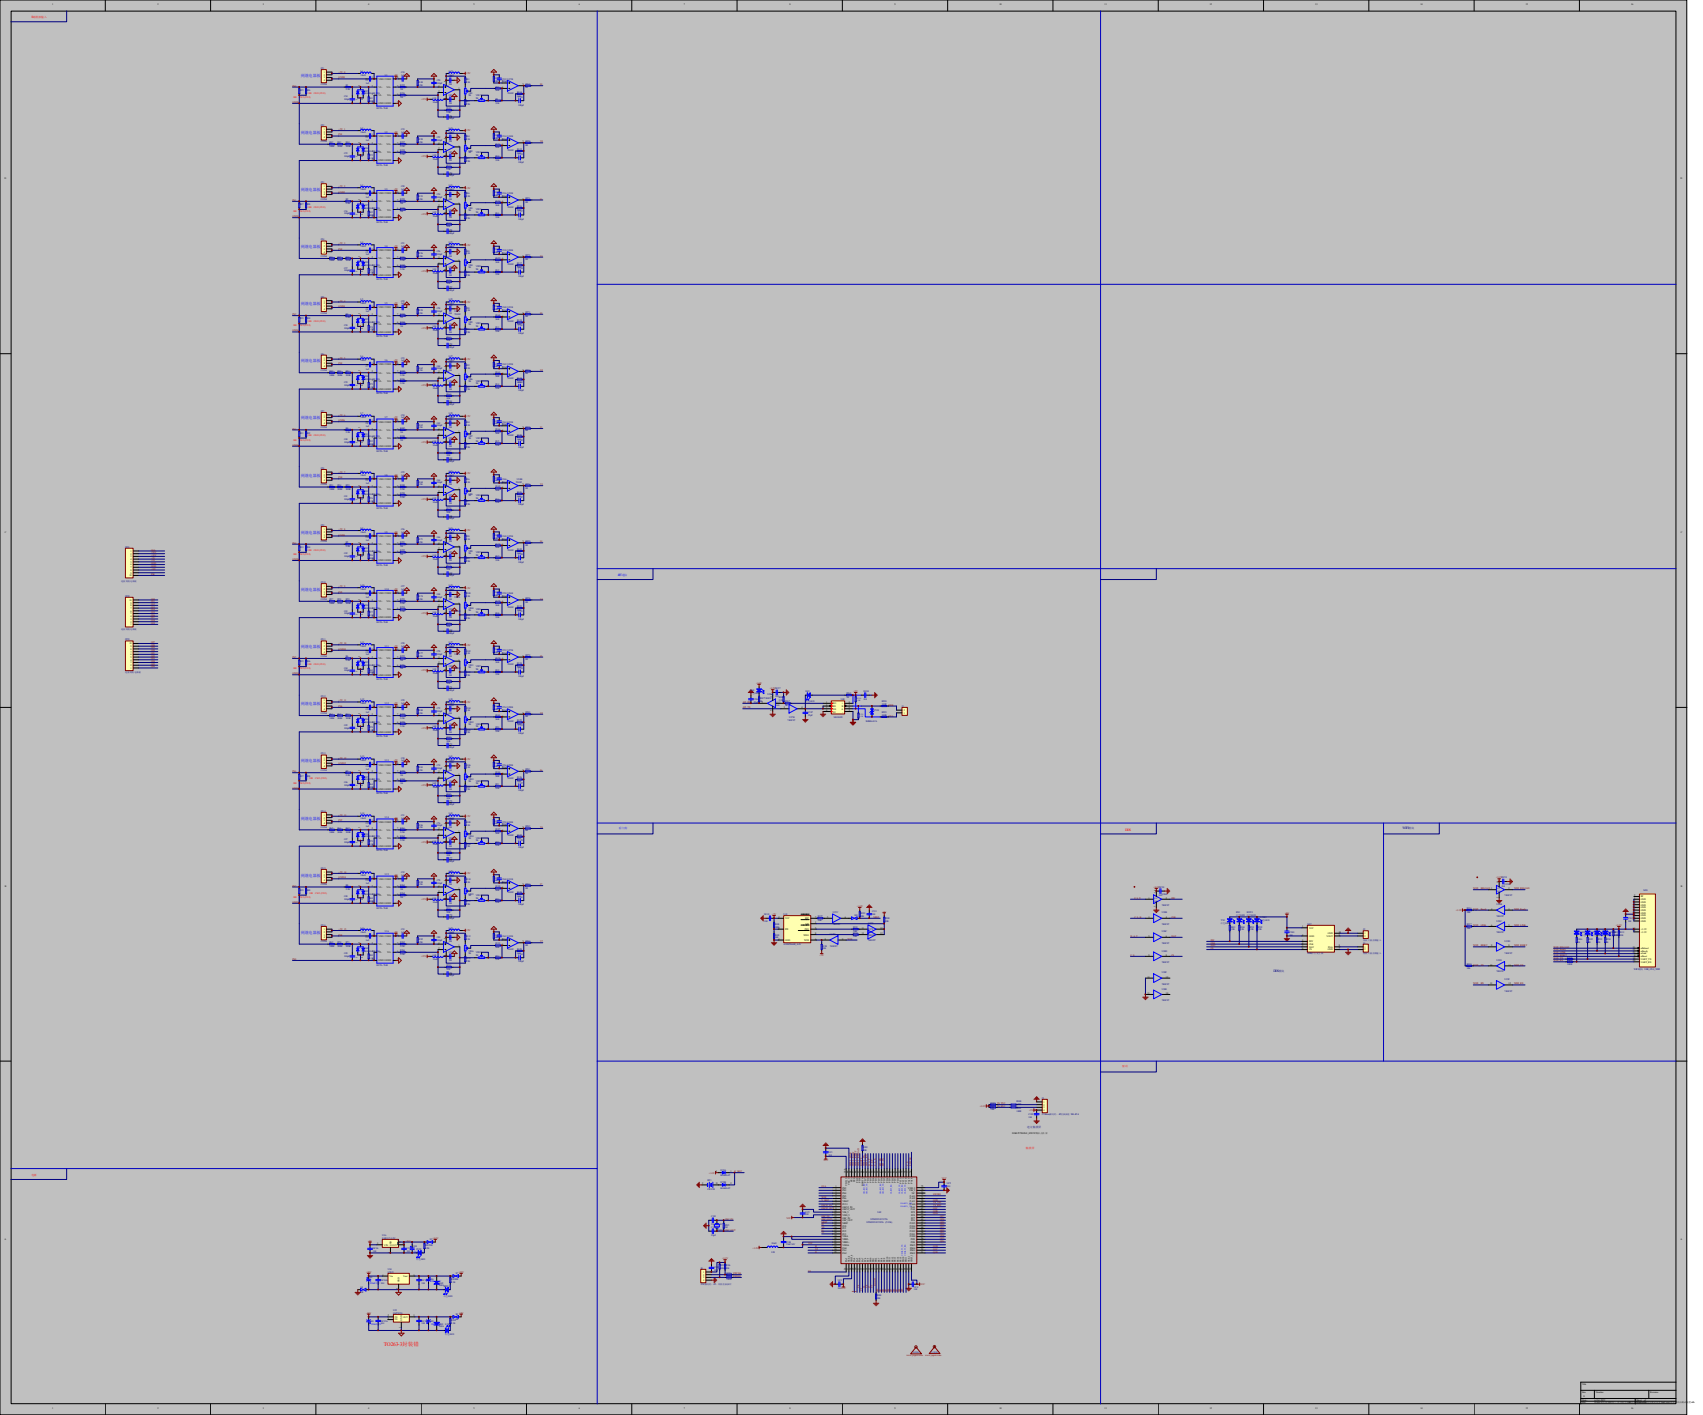
[picture p63: page 1]

SY CLK DAT CS
