LHC324/ABB-Technical-commutation_new/document/Sphinx/测试仪图纸/电线夹.PDF

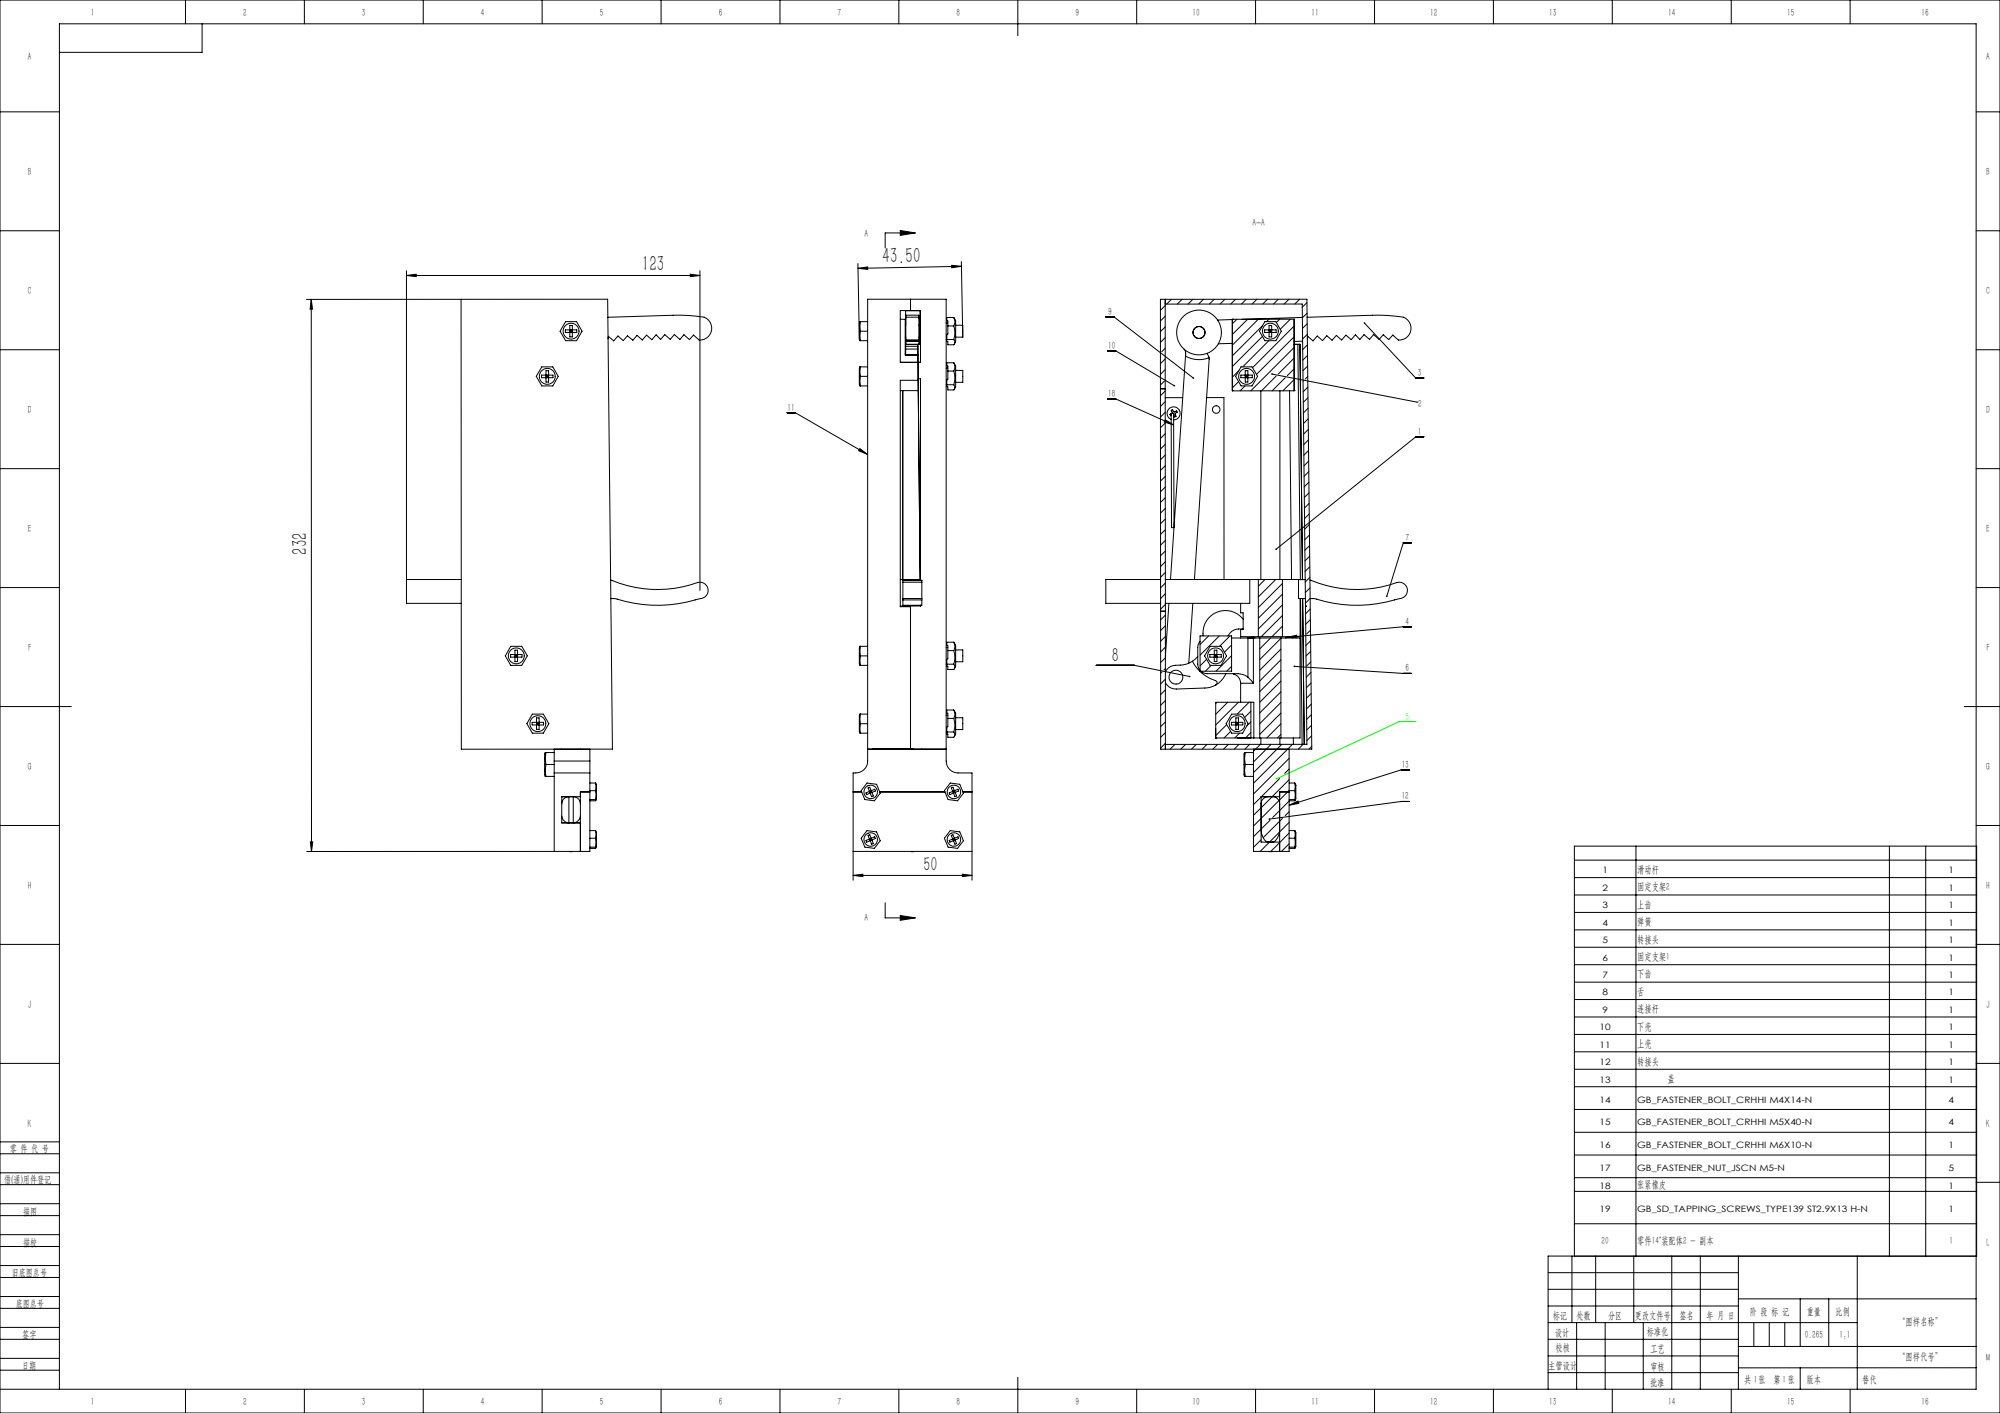
[picture p64: page 1]

1 | 滑动杆 | 1
2 | 固定支架2 | 1
3 | 上齿 | 1
4 | 弹簧 | 1
5 | 转接头 | 1
6 | 固定支架1 | 1
7 | 下齿 | 1
9 | 连接杆 | 1
10 | 下壳 | 1
11 | 上壳 | 1
12 | 转接头 | 1
13 | 盖 | 1
14 | GB_FASTENER_BOLT_CRHHI M4X14-N | 4
15 | GB_FASTENER_BOLT_CRHHI M5X40-N | 4
16 | GB_FASTENER_BOLT_CRHHI M6X10-N | 1
17 | GB_FASTENER_NUT_JSCN M5-N | 5
18 | 张紧橡皮 | 1
19 | GB_SD_TAPPING_SCREWS_TYPE139 ST2.9X13 H-N | 1

20 | 零件14^装配体2 - 副本 | 1

标记 | 处数 | 分区 | 更改文件号 | 签名 | 年 月 日
设计 | | | 标准化 | | | | | | | 0.265 | 1:1
校核 | | | 工艺
主管设计 | | | 审核

阶 段 标 记 | 重量 | 比例 | “图样名称”

“图样代号”
