LHC324/ABB-Technical-commutation_new/(list of files, drawings)

Other design files:
document/proteus/均压测试仪.pdsprj
