LHC324/ABB-Technical-commutation_new/board/CubeMX_Config/CubeMX_Config.ioc

Mcu.UserName=STM32F103VETx
PA0-WKUP.Signal=ADCx_IN0
PA1.Signal=ADCx_IN1
PA13.Signal=SYS_JTMS-SWDIO
PA14.Signal=SYS_JTCK-SWCLK
PA15.GPIO_Label=C_S
PA15.Signal=GPIO_Output
PA2.Signal=ADCx_IN2
PA4.Signal=COMP_DAC1_group
PA5.GPIO_Label=ACV_ZERO
PA5.Signal=GPXTI5
PA6.GPIO_Label=AI_SHORT
PA6.Signal=GPIO_Input
PA7.GPIO_Label=AI_RESET
PA7.Signal=GPIO_Output
PB10.GPIO_Label=Q19
PB10.Signal=GPIO_Output
PB12.GPIO_Label=Q1A
PB12.Signal=GPIO_Output
PB13.GPIO_Label=Q2A
PB13.Signal=GPIO_Output
PB3.Signal=SPI1_SCK
PB4.GPIO_Label=FSYCN
PB4.Signal=GPIO_Output
PB5.Signal=SPI1_MOSI
PB6.Signal=USART1_TX
PB7.Signal=USART1_RX
PB8.GPIO_Label=WIFI_RELOAD
PB8.Signal=GPIO_Output
PB9.GPIO_Label=WIFI_RESET
PB9.Signal=GPIO_Output
PC10.Signal=USART3_TX
PC11.Signal=USART3_RX
PC14-OSC32_IN.Signal=RCC_OSC32_IN
PC15-OSC32_OUT.Signal=RCC_OSC32_OUT
PC6.GPIO_Label=Q28
PC6.Signal=GPIO_Output
PC7.GPIO_Label=Q29
PC7.Signal=GPIO_Output
PC8.GPIO_Label=Q1B
PC8.Signal=GPIO_Output
PD0.GPIO_Label=CS12
PD0.Signal=GPIO_Output
PD1.GPIO_Label=CS11
PD1.Signal=GPIO_Output
PD10.GPIO_Label=Q22
PD10.Signal=GPIO_Output
PD11.GPIO_Label=Q23
PD11.Signal=GPIO_Output
PD12.GPIO_Label=Q24
PD12.Signal=GPIO_Output
PD13.GPIO_Label=Q25
PD13.Signal=GPIO_Output
PD14.GPIO_Label=Q26
PD14.Signal=GPIO_Output
PD15.GPIO_Label=Q27
PD15.Signal=GPIO_Output
PD2.GPIO_Label=CS10
PD2.Signal=GPIO_Output
PD3.GPIO_Label=CS02
PD3.Signal=GPIO_Output
PD4.GPIO_Label=CS01
PD4.Signal=GPIO_Output
PD5.Signal=USART2_TX
PD6.Signal=USART2_RX
PD7.GPIO_Label=CS00
PD7.Signal=GPIO_Output
PE0.GPIO_Label=WIFI_READY
PE0.Signal=GPIO_Input
PE1.GPIO_Label=WIFI_LINK
PE1.Signal=GPIO_Input
PE10.GPIO_Label=Q13
PE10.Signal=GPIO_Output
PE11.GPIO_Label=Q14
PE11.Signal=GPIO_Output
PE12.GPIO_Label=Q15
PE12.Signal=GPIO_Output
PE13.GPIO_Label=Q16
PE13.Signal=GPIO_Output
PE14.GPIO_Label=Q17
PE14.Signal=GPIO_Output
PE15.GPIO_Label=Q18
PE15.Signal=GPIO_Output
PE6.GPIO_Label=WDI
PE6.Signal=GPIO_Output
PE7.GPIO_Label=Q10
PE7.Signal=GPIO_Output
PE8.GPIO_Label=Q11
PE8.Signal=GPIO_Output
PE9.GPIO_Label=Q12
PE9.Signal=GPIO_Output
