LHC324/ABB-Technical-commutation_new/board/CubeMX_Config/Core/Src/main.c

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
/* Includes ------------------------------------------------------------------*/
#include "main.h"

/* USER CODE BEGIN Includes */
#include <rtthread.h>
/* USER CODE END Includes */

 ADC_HandleTypeDef hadc1;
ADC_HandleTypeDef hadc2;
ADC_HandleTypeDef hadc3;
DMA_HandleTypeDef hdma_adc1;
DMA_HandleTypeDef hdma_adc3;

DAC_HandleTypeDef hdac;

SPI_HandleTypeDef hspi1;

TIM_HandleTypeDef htim8;

UART_HandleTypeDef huart1;
UART_HandleTypeDef huart2;
UART_HandleTypeDef huart3;
DMA_HandleTypeDef hdma_usart1_rx;
DMA_HandleTypeDef hdma_usart1_tx;
DMA_HandleTypeDef hdma_usart2_rx;
DMA_HandleTypeDef hdma_usart2_tx;

void SystemClock_Config(void);
static void MX_GPIO_Init(void);
static void MX_DMA_Init(void);
static void MX_USART1_UART_Init(void);
static void MX_USART2_UART_Init(void);
static void MX_USART3_UART_Init(void);
static void MX_ADC1_Init(void);
static void MX_SPI1_Init(void);
static void MX_ADC2_Init(void);
static void MX_ADC3_Init(void);
static void MX_TIM8_Init(void);
static void MX_DAC_Init(void);
/* USER CODE BEGIN 0 */
static int rt_stm32_hal_init(void)
{
  HAL_Init();
  MX_GPIO_Init();
  MX_DMA_Init();
  MX_USART1_UART_Init();
  MX_USART2_UART_Init();
  MX_USART3_UART_Init();
  MX_TIM8_Init();
  MX_ADC1_Init();
  MX_ADC2_Init();
  MX_ADC3_Init();
  MX_DAC_Init();
  MX_SPI1_Init();

  HAL_ADCEx_Calibration_Start(&hadc1);
  HAL_ADCEx_Calibration_Start(&hadc2);
  HAL_ADCEx_Calibration_Start(&hadc3);
  HAL_DAC_SetValue(&hdac, DAC_CHANNEL_1, DAC_ALIGN_12B_R, 2048 - 1); // 输出基准电压1.65v
  HAL_DAC_Start(&hdac, DAC_CHANNEL_1);
  /*启动时复位一下wifi*/
  // HAL_GPIO_WritePin(WIFI_RESET_GPIO_Port, WIFI_RESET_Pin, GPIO_PIN_RESET);
  // HAL_Delay(100);
  // HAL_GPIO_WritePin(WIFI_RESET_GPIO_Port, WIFI_RESET_Pin, GPIO_PIN_SET);
  return 0;
}
/*在内核对象中初始�????????????:https://blog.csdn.net/yang1111111112/article/details/93982354*/
// INIT_COMPONENT_EXPORT(rt_stm32_hal_init);
// INIT_ENV_EXPORT(rt_stm32_hal_init);
INIT_DEVICE_EXPORT(rt_stm32_hal_init);
/* USER CODE END 0 */

/**
  * @brief  The application entry point.
  * @retval int
  */

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
