LHC324/ABB-Technical-commutation_new/board/CubeMX_Config/Core/Inc/main.h

#define WDI_Pin GPIO_PIN_6
#define WDI_GPIO_Port GPIOE
#define ACV_ZERO_Pin GPIO_PIN_5
#define ACV_ZERO_GPIO_Port GPIOA
#define AI_SHORT_Pin GPIO_PIN_6
#define AI_SHORT_GPIO_Port GPIOA
#define AI_RESET_Pin GPIO_PIN_7
#define AI_RESET_GPIO_Port GPIOA
#define Q10_Pin GPIO_PIN_7
#define Q10_GPIO_Port GPIOE
#define Q11_Pin GPIO_PIN_8
#define Q11_GPIO_Port GPIOE
#define Q12_Pin GPIO_PIN_9
#define Q12_GPIO_Port GPIOE
#define Q13_Pin GPIO_PIN_10
#define Q13_GPIO_Port GPIOE
#define Q14_Pin GPIO_PIN_11
#define Q14_GPIO_Port GPIOE
#define Q15_Pin GPIO_PIN_12
#define Q15_GPIO_Port GPIOE
#define Q16_Pin GPIO_PIN_13
#define Q16_GPIO_Port GPIOE
#define Q17_Pin GPIO_PIN_14
#define Q17_GPIO_Port GPIOE
#define Q18_Pin GPIO_PIN_15
#define Q18_GPIO_Port GPIOE
#define Q19_Pin GPIO_PIN_10
#define Q19_GPIO_Port GPIOB
#define Q1A_Pin GPIO_PIN_12
#define Q1A_GPIO_Port GPIOB
#define Q2A_Pin GPIO_PIN_13
#define Q2A_GPIO_Port GPIOB
#define Q22_Pin GPIO_PIN_10
#define Q22_GPIO_Port GPIOD
#define Q23_Pin GPIO_PIN_11
#define Q23_GPIO_Port GPIOD
#define Q24_Pin GPIO_PIN_12
#define Q24_GPIO_Port GPIOD
#define Q25_Pin GPIO_PIN_13
#define Q25_GPIO_Port GPIOD
#define Q26_Pin GPIO_PIN_14
#define Q26_GPIO_Port GPIOD
#define Q27_Pin GPIO_PIN_15
#define Q27_GPIO_Port GPIOD
#define Q28_Pin GPIO_PIN_6
#define Q28_GPIO_Port GPIOC
#define Q29_Pin GPIO_PIN_7
#define Q29_GPIO_Port GPIOC
#define Q1B_Pin GPIO_PIN_8
#define Q1B_GPIO_Port GPIOC
#define C_S_Pin GPIO_PIN_15
#define C_S_GPIO_Port GPIOA
#define CS12_Pin GPIO_PIN_0
#define CS12_GPIO_Port GPIOD
#define CS11_Pin GPIO_PIN_1
#define CS11_GPIO_Port GPIOD
#define CS10_Pin GPIO_PIN_2
#define CS10_GPIO_Port GPIOD
#define CS02_Pin GPIO_PIN_3
#define CS02_GPIO_Port GPIOD
#define CS01_Pin GPIO_PIN_4
#define CS01_GPIO_Port GPIOD
#define CS00_Pin GPIO_PIN_7
#define CS00_GPIO_Port GPIOD
#define FSYCN_Pin GPIO_PIN_4
#define FSYCN_GPIO_Port GPIOB
#define WIFI_RELOAD_Pin GPIO_PIN_8
#define WIFI_RELOAD_GPIO_Port GPIOB
#define WIFI_RESET_Pin GPIO_PIN_9
#define WIFI_RESET_GPIO_Port GPIOB
#define WIFI_READY_Pin GPIO_PIN_0
#define WIFI_READY_GPIO_Port GPIOE
#define WIFI_LINK_Pin GPIO_PIN_1
#define WIFI_LINK_GPIO_Port GPIOE
