LHC324/ABB-Technical-commutation_new/(commit log)

2022-11-03 首次提交。
    [AD采样值.xls, kconfig-language.txt, kconfig.txt, 均匀测试_迪文屏幕_RAM变量分配表.xlsx, 电线夹.DXF, 电线夹.SLDDRW, 电线夹二维图.DXF, 电线夹二维图.SLDDRW]
2022-12-02 本次提交变化如下： 1、重新定义了‘rt_thread_pools_t’结构使用方法。 2、对dwin接口怎加了标准的数据录入新方式。 3、完善了‘struct test_handletypedef’结构。 4、增加了‘littlefs’文件系统、‘libcsv’、‘minIni’库支持。 5、改变了原有系统参数的存储结构，使用‘config.ini’文件。 6、丢弃了原‘flash.c’中自定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
    [均匀测试_迪文屏幕_RAM变量分配表.xlsx, 均压测试仪_AC信号分析.xlsx, 继电器动作策略.xlsx, 远程升级Flash划分.xlsx]
2022-12-09 本次提交变化如下： 1、对modbus协议站中‘Modbus_Operatex’函数进行空指针操作检查。 2、对modbus协议站中‘Mod_Ota’功能进行了扩展，支持标准modbus和finsh控制台任意切换。 3、对modbus协议站适配了标准的‘rt thread’的device框架。 4、变更了rt thread底层串口驱动版本为V2。 5、完善了对‘.csv’文件的编号自增、校验、循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
    [电压、电流校准.xlsx]
2022-12-18 本次提交变化如下： 1、调整了finsh线程优先级：20->8,改变了uart3的RX接收缓冲区尺寸：256->1024,为了解决ymodem协议进行ota经常失败问题。 2、对“ymodem.c”源码378做出了修改，增加了单次数据传输失败后请求重发，最大15次的机制。 3、对adc采样得到的电压、电流进行了标定（原理性错误，标定失败）。 4、对at模块源码进行了调整（“at_client.c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
    [电压、电流校准.xlsx]
2022-12-23 本次提交变化如下： 1、修正了过流保护功能，能在正常工作过程中及时检测，并停止系统进行保护来避免安全事故。 2、还原了“finsh”控制台优先级：8->20。 3、在迪文屏幕的自动/手动模式中把原来的“电压”分为“电压1”和“电压2”，并在“.csv”文件中进行记录。 4、重新修正了电压、电流的校准系数。 5、修复了“swap_16bit_data_to_buf”（main.c:973） 函数中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
    [均匀测试_迪文屏幕_RAM变量分配表.xlsx, 电压、电流校准.xlsx]
2022-12-28 本次提交变化如下： 1 、修复了手动模式下，组号开始和结束逆序时可能导致宕机的问题。 2、调整了工作组继电器的next时间：15->5S。 3、调整了“relay.h”中“struct relay_handletypedef”结构，增加了“info”成员，使用位域存储，有效改善内存利用率。 4、增加了电压、电流偏差率的逆序计算功能。 5、解决了“rt ymodem”协议在网络串口模式下，频发的链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
    [main.c]
2023-02-21 本次提交变化如下： 1、修复“data.csv”不能正确循环存储数据问题。 2、重新标定了所有通道的校准系数。 3、对交流信号的处理适配了“fft”算法。 4、并且在测试过程中不允许清空屏幕数据。
    [均压测试仪.pdsprj, 均压测试仪_AC信号分析.xlsx, 均压测试仪_云平台变量模板.xlsx, 电压、电流校准.xlsx, 继电器动作策略.xlsx]
