LHC324/ABB-Technical-commutation_new/(notices)

Notices in the files:
board/CubeMX_Config/Core/Inc/main.h:
Copyright (c) 2022 STMicroelectronics.
All rights reserved.
This software is licensed under terms that can be found in the LICENSE file
